SamarthK154/Inverse-Pendulum/(list of files, cad)

Other CAD files:
CAD Files/MHPBF v5.f3d
CAD Files/PSB v1.f3d
CAD Files/fly v5.f3d
CAD Files/pendulum_shaft v2.f3d
