SamarthK154/Inverse-Pendulum/Arduino Code/IP_V4.ino

#include <Adafruit_Sensor.h>
#include <Adafruit_BusIO_Register.h>
#include <Adafruit_I2CDevice.h>
#include <Adafruit_I2CRegister.h>
#include <Adafruit_SPIDevice.h>
#include <Adafruit_BNO055.h>
#include <utility/imumaths.h>
#include <Wire.h>
#include <EEPROM.h>
#include <DynamixelShield.h>

#if defined(ARDUINO_AVR_UNO) || defined(ARDUINO_AVR_MEGA2560)
#include <SoftwareSerial.h>
SoftwareSerial soft_serial(7, 8);  // DYNAMIXELShield UART RX/TX
#define DEBUG_SERIAL soft_serial
#elif defined(ARDUINO_SAM_DUE) || defined(ARDUINO_SAM_ZERO)
#define DEBUG_SERIAL SerialUSB
#else
#define DEBUG_SERIAL Serial
#endif

const uint8_t DXL_ID = 1;
const float DXL_PROTOCOL_VERSION = 2.0;

DynamixelShield dxl;

//This namespace is required to use Control table item names
using namespace ControlTableItem;
#define BNO055_SAMPLERATE_DELAY_MS (100)
Adafruit_BNO055 bno = Adafruit_BNO055(55, 0x28, &Wire);
uint8_t gyro1, accel1, mag1 = 0;
void displaySensorDetails(void) {
  sensor_t sensor;
  bno.getSensor(&sensor);
  Serial.println("------------------------------------");
  Serial.print("Sensor:       ");
  Serial.println(sensor.name);
  Serial.print("Driver Ver:   ");
  Serial.println(sensor.version);
  Serial.print("Unique ID:    ");
  Serial.println(sensor.sensor_id);
  Serial.print("Max Value:    ");
  Serial.print(sensor.max_value);
  Serial.println(" xxx");
  Serial.print("Min Value:    ");
  Serial.print(sensor.min_value);
  Serial.println(" xxx");
  Serial.print("Resolution:   ");
  Serial.print(sensor.resolution);
  Serial.println(" xxx");
  Serial.println("------------------------------------");
  Serial.println("");
  delay(500);
}
void displaySensorStatus(void) {
  /* Get the system status values (mostly for debugging purposes) */
  uint8_t system_status, self_test_results, system_error;
  system_status = self_test_results = system_error = 0;
  bno.getSystemStatus(&system_status, &self_test_results, &system_error);

  /* Display the results in the Serial Monitor */
  Serial.println("");
  Serial.print("System Status: 0x");
  Serial.println(system_status, HEX);
  Serial.print("Self Test:     0x");
  Serial.println(self_test_results, HEX);
  Serial.print("System Error:  0x");
  Serial.println(system_error, HEX);
  Serial.println("");
  delay(500);
}
void displayCalStatus(void) {
  /* Get the four calibration values (0..3) */
  /* Any sensor data reporting 0 should be ignored, */
  /* 3 means 'fully calibrated" */
  uint8_t system, gyro, accel, mag;
  system = gyro = accel = mag = 0;
  bno.getCalibration(&system, &gyro, &accel, &mag);

  /* The data should be ignored until the system calibration is > 0 */
  Serial.print("\t");
  if (!system) {
    Serial.print("! ");
  }

  /* Display the individual values */
  Serial.print("Sys:");
  Serial.print(system, DEC);
  Serial.print(" G:");
  Serial.print(gyro, DEC);
  Serial.print(" A:");
  Serial.print(accel, DEC);
  Serial.print(" M:");
  Serial.println(mag, DEC);
  gyro1 = gyro;
  accel1 = accel;
  mag1 = mag;
}
//initialise motor and sensor
//
void setup() {
  /// put your setup code here, to run once:

  // For Uno, Nano, Mini, and Mega, use UART port of DYNAMIXEL Shield to debug.
  DEBUG_SERIAL.begin(115200);

  // Set Port baudrate to 57600bps. This has to match with DYNAMIXEL baudrate.
  dxl.begin(57600);
  // Set Port Protocol Version. This has to match with DYNAMIXEL protocol version.
  dxl.setPortProtocolVersion(DXL_PROTOCOL_VERSION);
  // Get DYNAMIXEL information
  dxl.ping(DXL_ID);

  // Turn off torque when configuring items in EEPROM area
  dxl.torqueOff(DXL_ID);
  dxl.setOperatingMode(DXL_ID, OP_PWM);
  dxl.torqueOn(DXL_ID);

  pinMode(A0, INPUT);
  pinMode(A1, INPUT);
  pinMode(A2, INPUT);

  Serial.begin(9600);
  while (!Serial) delay(10);  // wait for serial port to open!

  Serial.println("Orientation Sensor Test");
  Serial.println("");

  /* Initialise the sensor */
  if (!bno.begin()) {
    /* There was a problem detecting the BNO055 ... check your connections */
    Serial.print("Ooops, no BNO055 detected ... Check your wiring or I2C ADDR!");
    while (1)
      ;
  }

  int eeAddress = 0;
  long bnoID;
  bool foundCalib = false;

  EEPROM.get(eeAddress, bnoID);

  adafruit_bno055_offsets_t calibrationData;
  sensor_t sensor;

  /*
    *  Look for the sensor's unique ID at the beginning oF EEPROM.
    *  This isn't foolproof, but it's better than nothing.
    */
  bno.getSensor(&sensor);
  if (bnoID != sensor.sensor_id) {
    Serial.println("\nNo Calibration Data for this sensor exists in EEPROM");
    delay(500);
  } else {
    Serial.println("\nFound Calibration for this sensor in EEPROM.");
    eeAddress += sizeof(long);
    EEPROM.get(eeAddress, calibrationData);

    displaySensorOffsets(calibrationData);

    Serial.println("\n\nRestoring Calibration data to the BNO055...");
    bno.setSensorOffsets(calibrationData);

    Serial.println("\n\nCalibration data loaded into BNO055");
    foundCalib = true;
  }

  delay(1000);

  /* Display some basic information on this sensor */
  displaySensorDetails();

  /* Optional: Display current status */
  displaySensorStatus();

  /* Crystal must be configured AFTER loading calibration data into BNO055. */
  bno.setExtCrystalUse(true);

  sensors_event_t event;
  bno.getEvent(&event);
  /* always recal the mag as It goes out of calibration very often */
  if (foundCalib) {
    Serial.println("Move sensor slightly to calibrate magnetometers");
    while (bno.isFullyCalibrated() != true) {
      bno.getEvent(&event);
      displayCalStatus();
      delay(BNO055_SAMPLERATE_DELAY_MS);
    }
    delay(10000);
  } else {
    Serial.println("Please Calibrate Sensor: ");
    while (!bno.isFullyCalibrated()) {
      bno.getEvent(&event);

      Serial.print("X: ");
      Serial.print(event.orientation.x, 4);
      Serial.print("\tY: ");
      Serial.print(event.orientation.y, 4);
      Serial.print("\tZ: ");
      Serial.print(event.orientation.z, 4);

      /* Optional: Display calibration status */
      displayCalStatus();

      /* New line for the next sample */
      Serial.println("");

      /* Wait the specified delay before requesting new data */
      delay(BNO055_SAMPLERATE_DELAY_MS);
    }
    Serial.println("\nFully calibrated!");
    Serial.println("--------------------------------");
    Serial.println("Calibration Results: ");
    adafruit_bno055_offsets_t newCalib;
    bno.getSensorOffsets(newCalib);
    displaySensorOffsets(newCalib);

    Serial.println("\n\nStoring calibration data to EEPROM...");

    eeAddress = 0;
    bno.getSensor(&sensor);
    bnoID = sensor.sensor_id;

    EEPROM.put(eeAddress, bnoID);

    eeAddress += sizeof(long);
    EEPROM.put(eeAddress, newCalib);
    Serial.println("Data stored to EEPROM.");

    Serial.println("\n--------------------------------\n");
  }

  delay(10000);
}

float Kp = 8;
float Kv = 0.;
float Ki = 0.5;
float errI = 0;

int KpMax = 100;
int KvMax = 10;
int KiMax = 5;

void loop() {

  // Potentiometer input
  int kp_pot = analogRead(A0);
  int kv_pot = analogRead(A1);
  int ki_pot = analogRead(A2);
  // Map the potentiometer values to the desired ranges
  float Kp = my_map(kp_pot, 0, 1023, 0, KpMax);
  float Kv = my_map(kv_pot, 0, 1023, 0, KvMax);
  float Ki = my_map(ki_pot, 0, 1023, 0, KiMax);

  int16_t s = 0;
  sensors_event_t event;
  bno.getEvent(&event);
  imu::Vector<3> euler = bno.getVector(Adafruit_BNO055::VECTOR_EULER);
  imu::Vector<3> angvel = bno.getVector(Adafruit_BNO055::VECTOR_GYROSCOPE);

  float z = -euler.z();
  float av = angvel.z();
  int av10 = 10 * av;
  float av_c = float(av10) / 10;
  // Serial.println(String(angvel.x()) + "," + String(angvel.y()) + "," + String(angvel.z()));

  float err_pos = (0 - z);
  float err_vel = (0 - av_c);
  errI = errI + (0 - z) * 0.001;

  if (abs(z) < 18.) {
    s = (-Kp * err_pos - Kv * err_vel - Ki * errI);
  } else {
    s = 0;
  }

  if (s > 800) { s = 800; }
  if (s < -800) { s = -800; }
  if (abs(z) <= 0.5) { s = 0; }
  float s1 = s / 885;
  dxl.setGoalPWM(DXL_ID, s1, UNIT_PERCENT);
  DEBUG_SERIAL.print("M: ");
  DEBUG_SERIAL.print(s);
  DEBUG_SERIAL.print(" Z: ");
  DEBUG_SERIAL.print(z);
  DEBUG_SERIAL.print(" AV: ");
  DEBUG_SERIAL.print(av);
  DEBUG_SERIAL.print(" Kp: ");
  DEBUG_SERIAL.print(Kp);
  DEBUG_SERIAL.print(" Kv: ");
  DEBUG_SERIAL.print(Kv);
  DEBUG_SERIAL.print(" Ki: ");
  DEBUG_SERIAL.print(Ki);
  DEBUG_SERIAL.println();
  delay(10);
}

/**************************************************************************/
/*
    Display the raw calibration offset and radius data
    */
/**************************************************************************/
void displaySensorOffsets(const adafruit_bno055_offsets_t &calibData) {
  Serial.print("Accelerometer: ");
  Serial.print(calibData.accel_offset_x);
  Serial.print(" ");
  Serial.print(calibData.accel_offset_y);
  Serial.print(" ");
  Serial.print(calibData.accel_offset_z);
  Serial.print(" ");

  Serial.print("\nGyro: ");
  Serial.print(calibData.gyro_offset_x);
  Serial.print(" ");
  Serial.print(calibData.gyro_offset_y);
  Serial.print(" ");
  Serial.print(calibData.gyro_offset_z);
  Serial.print(" ");

  Serial.print("\nMag: ");
  Serial.print(calibData.mag_offset_x);
  Serial.print(" ");
  Serial.print(calibData.mag_offset_y);
  Serial.print(" ");
  Serial.print(calibData.mag_offset_z);
  Serial.print(" ");

  Serial.print("\nAccel Radius: ");
  Serial.print(calibData.accel_radius);

  Serial.print("\nMag Radius: ");
  Serial.print(calibData.mag_radius);
}

float my_map(int value, int fromLow, int fromHigh, float toLow, float toHigh) {
  return (value - fromLow) * (toHigh - toLow) / (fromHigh - fromLow) + toLow;
}
