SamarthK154/Inverse-Pendulum/(commit log)

2024-08-04 Create Arduino Code
2024-08-04 Create CAD Files
